versioduo/step/hardware/step.pdf

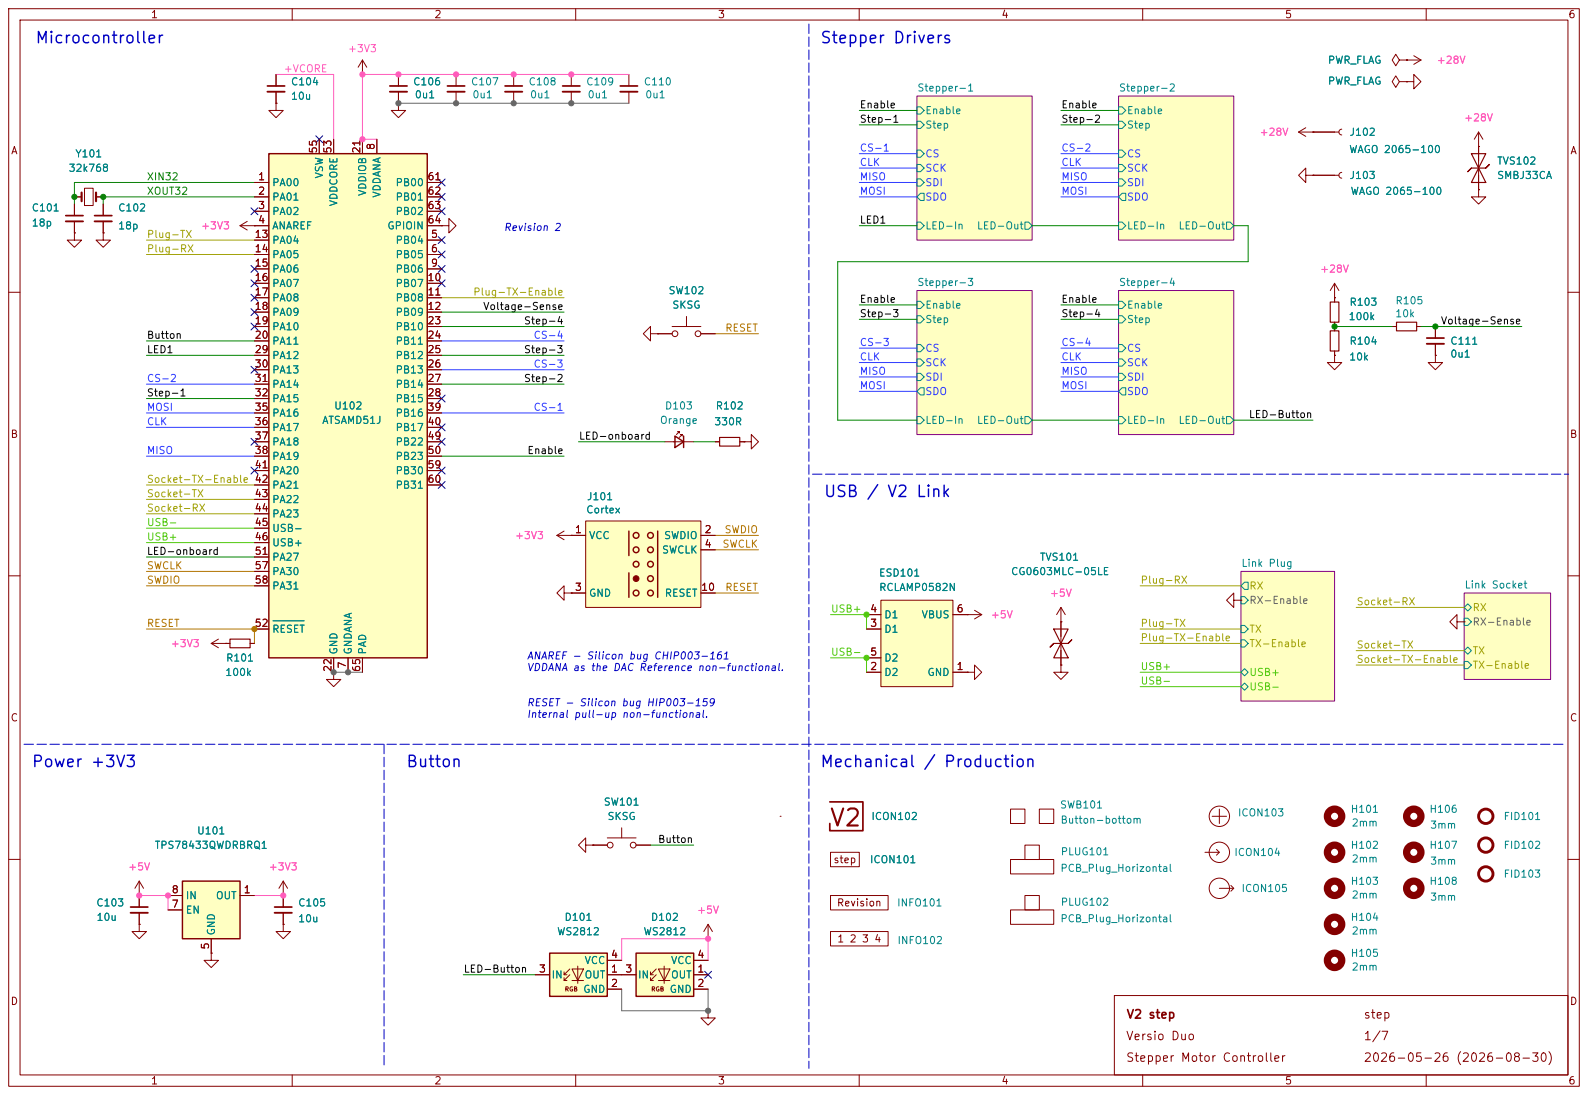
[picture p1: page 1]

LED-Out Stepper-4 CS

LED-Out Stepper-2 CS
Enable SDI LED-In SCK
Enable Step-1 MISO

Step

CS-4 MOSI XOUT32 Button CS-2
LED-Out Stepper-3 C102
Plug-TX

Step-4
LED-onboard CS-4 CS-3
Step-3

Plug-TX-Enable MISO

LED-onboard Socket-TX-Enable USB-
Socket-RX

VDDANA as the DAC Reference non-functional. Power +3V3

RESET - Silicon bug HIP003-159
Internal pull-up non-functional.

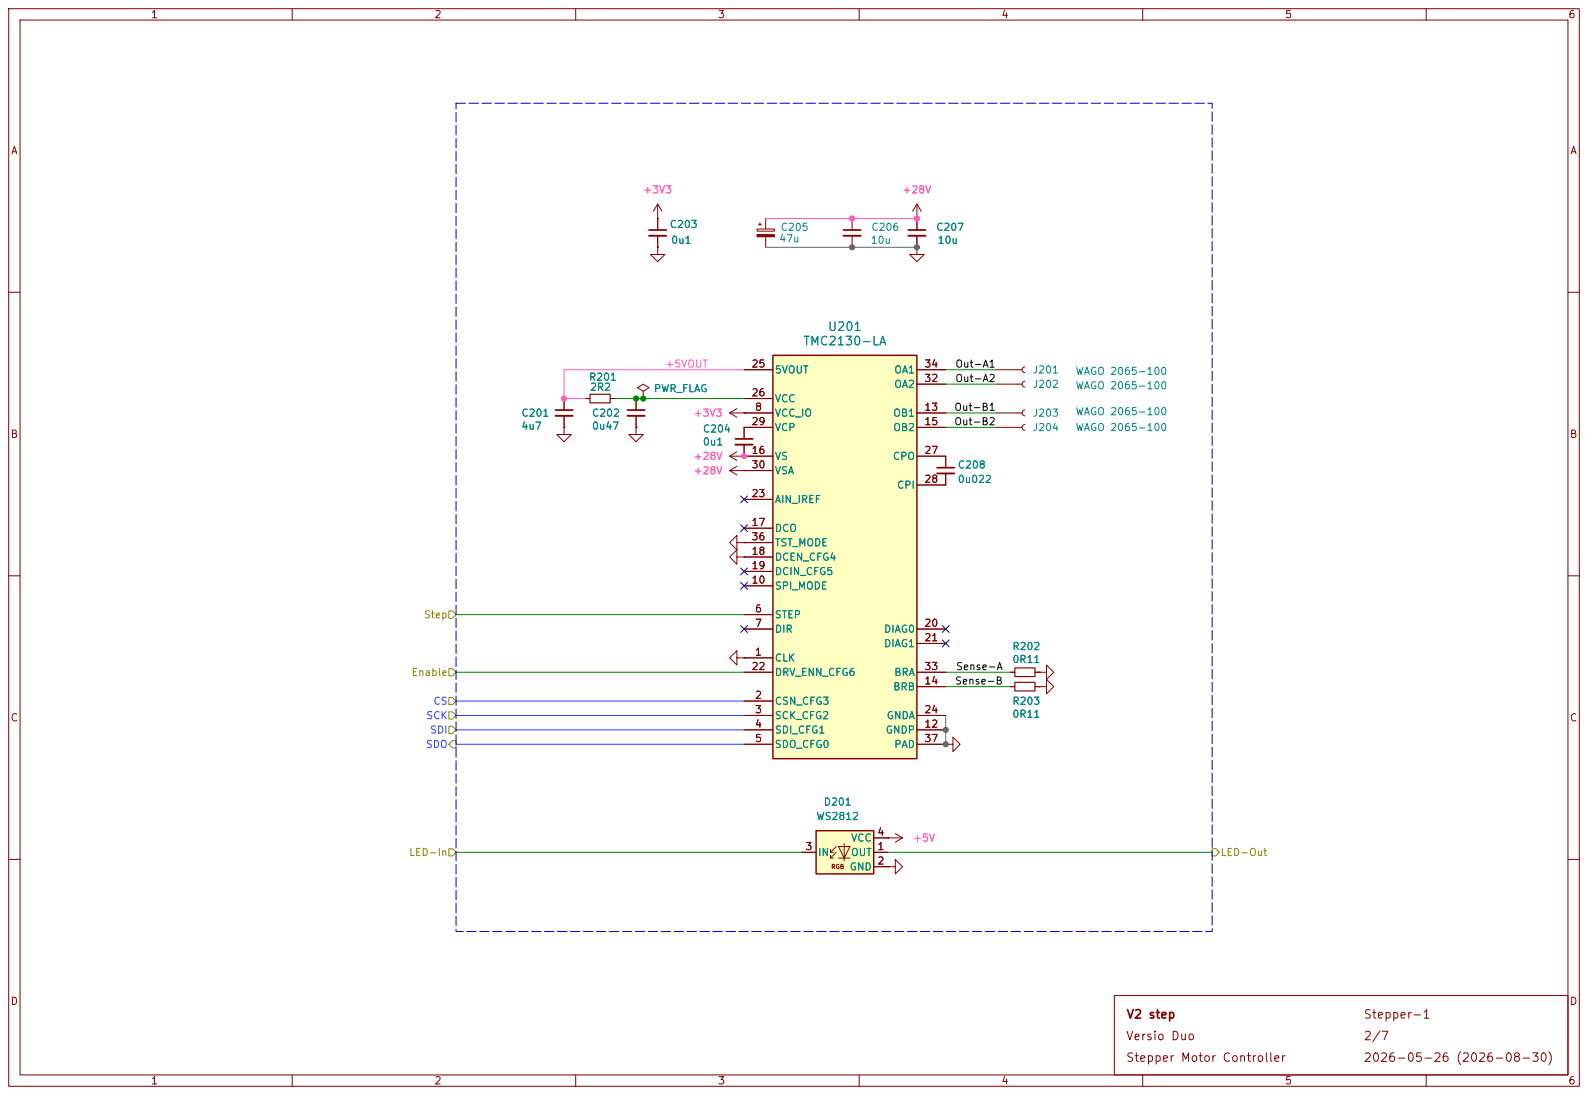
[picture p2: page 2]

0u1 PWR_FLAG

VCC_IO 8

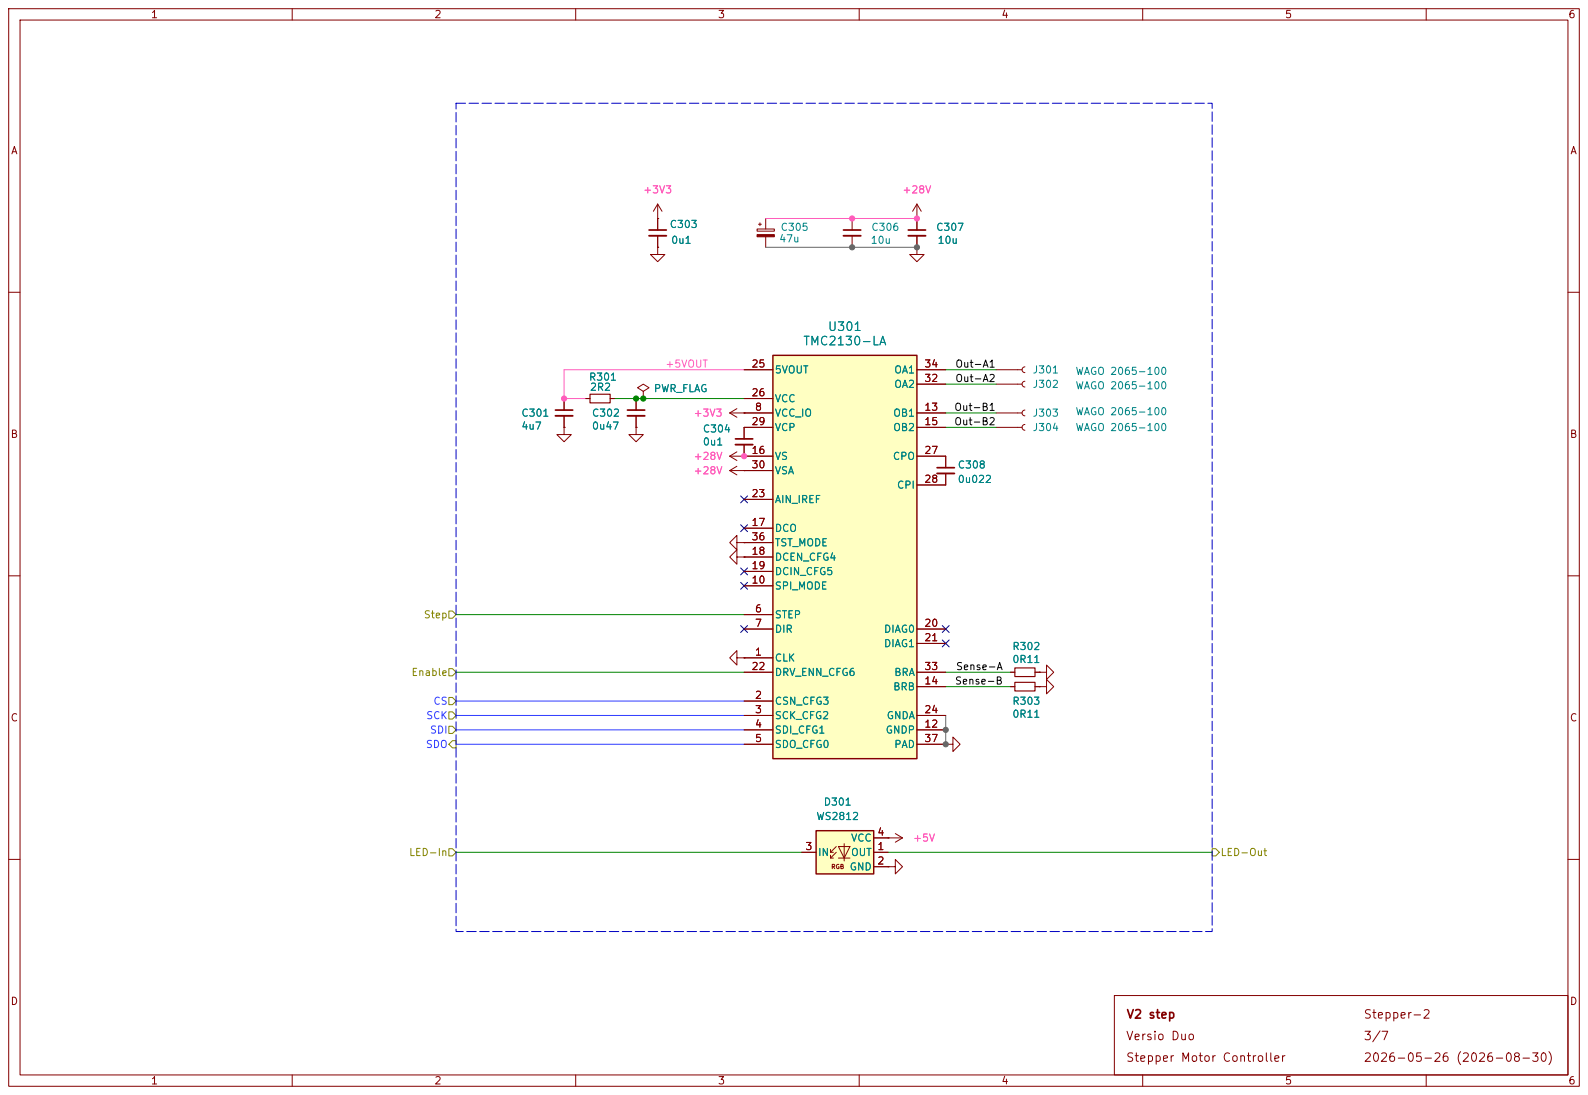
[picture p3: page 3]

CLK 1 CSN_CFG3 2 47u +28V VCC_IO 8 VCC_IO 8

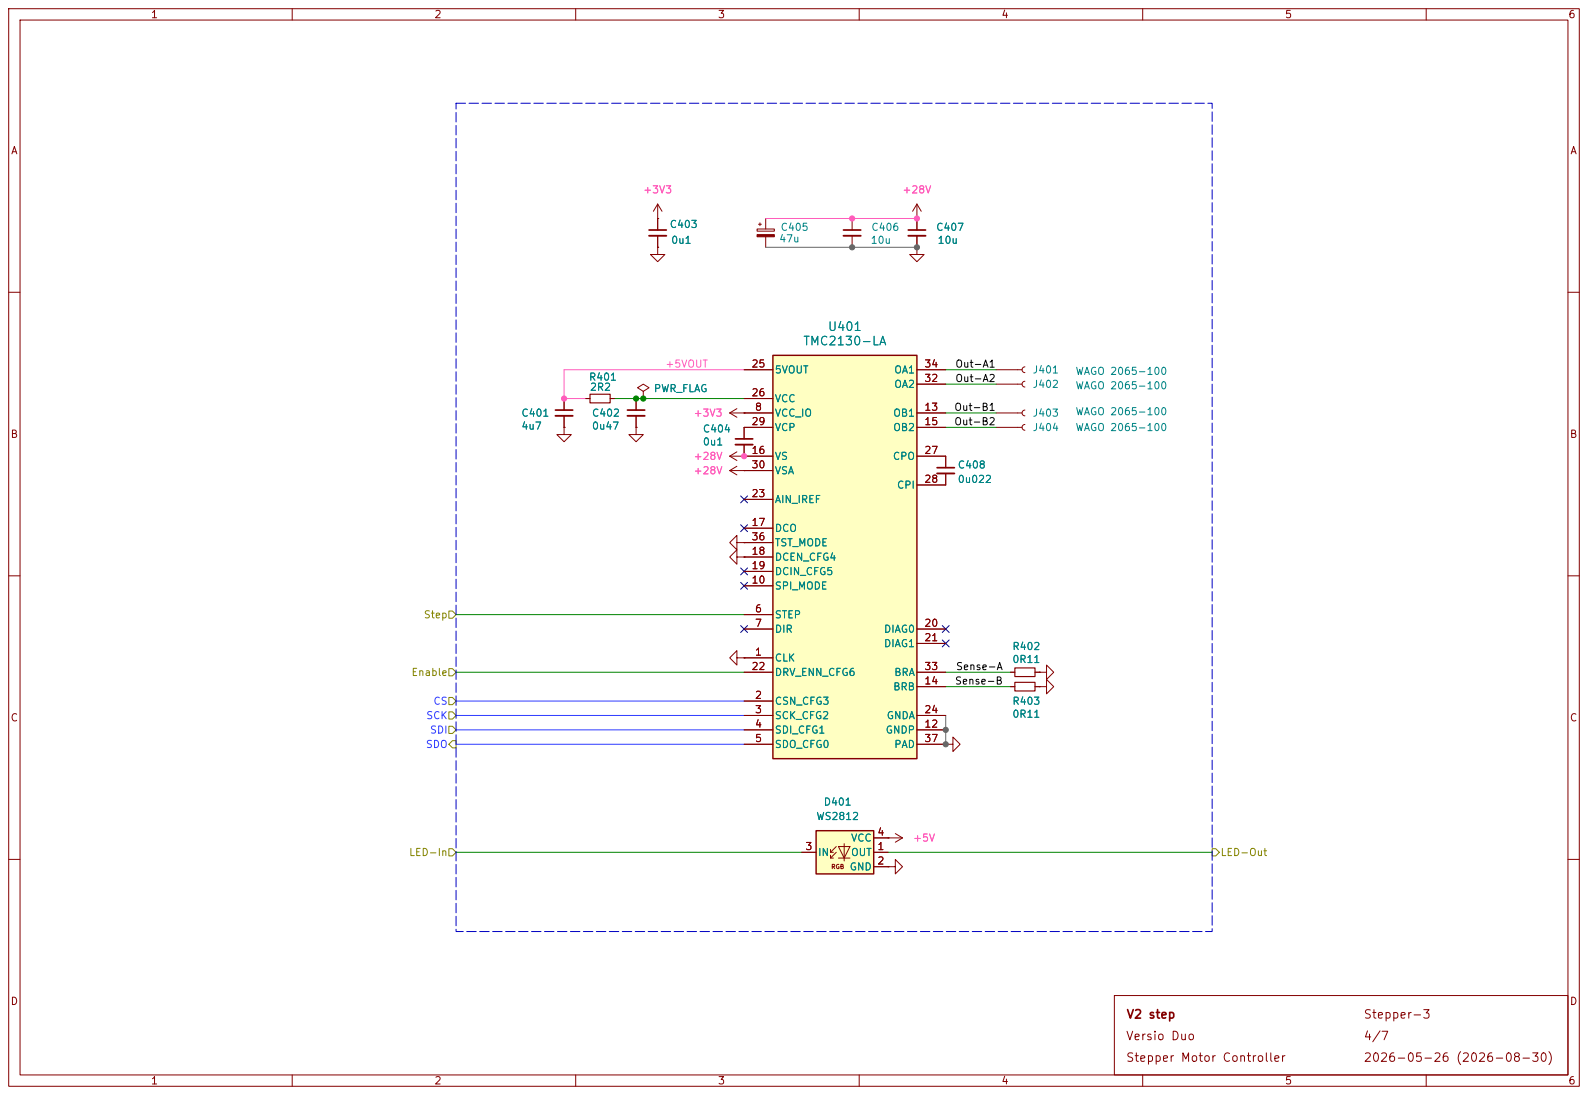
[picture p4: page 4]

0u1 +28V +3V3 +28V | VCC_IO 8

LED-Out Enable SDI CS
LED-In SDO

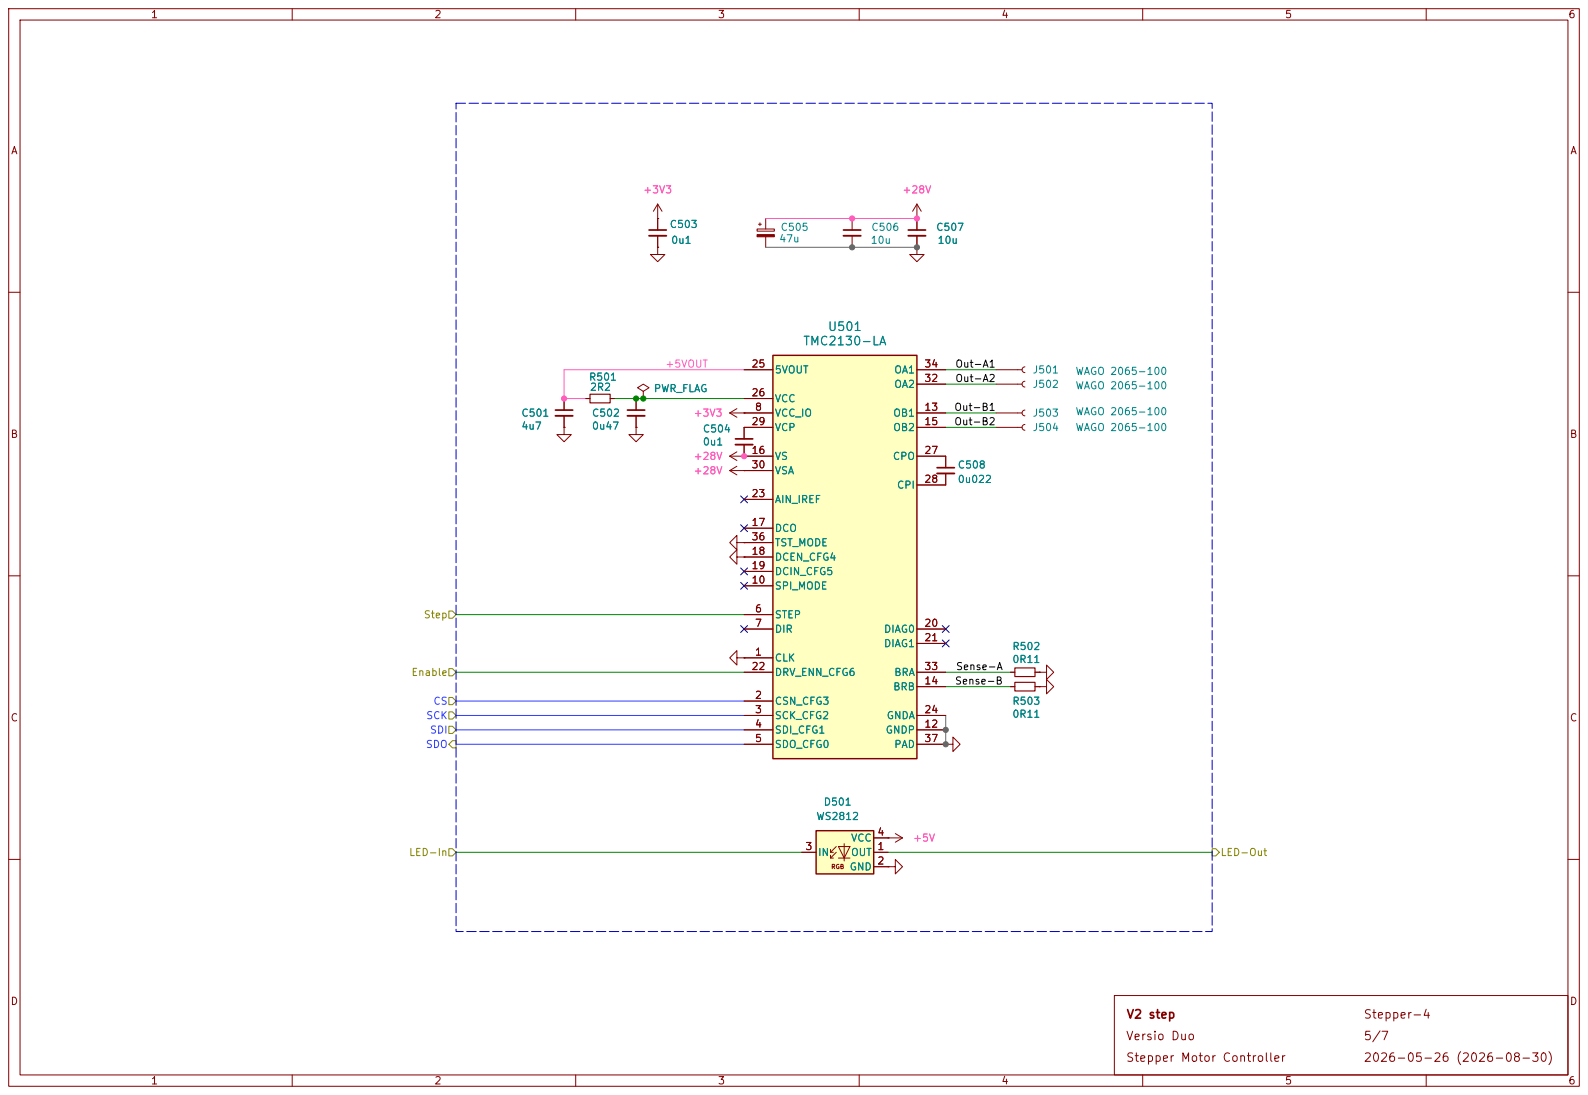
[picture p5: page 5]

TMC2130-LA +28V VCC_IO 8 VCC_IO 8 | Sense-A C507

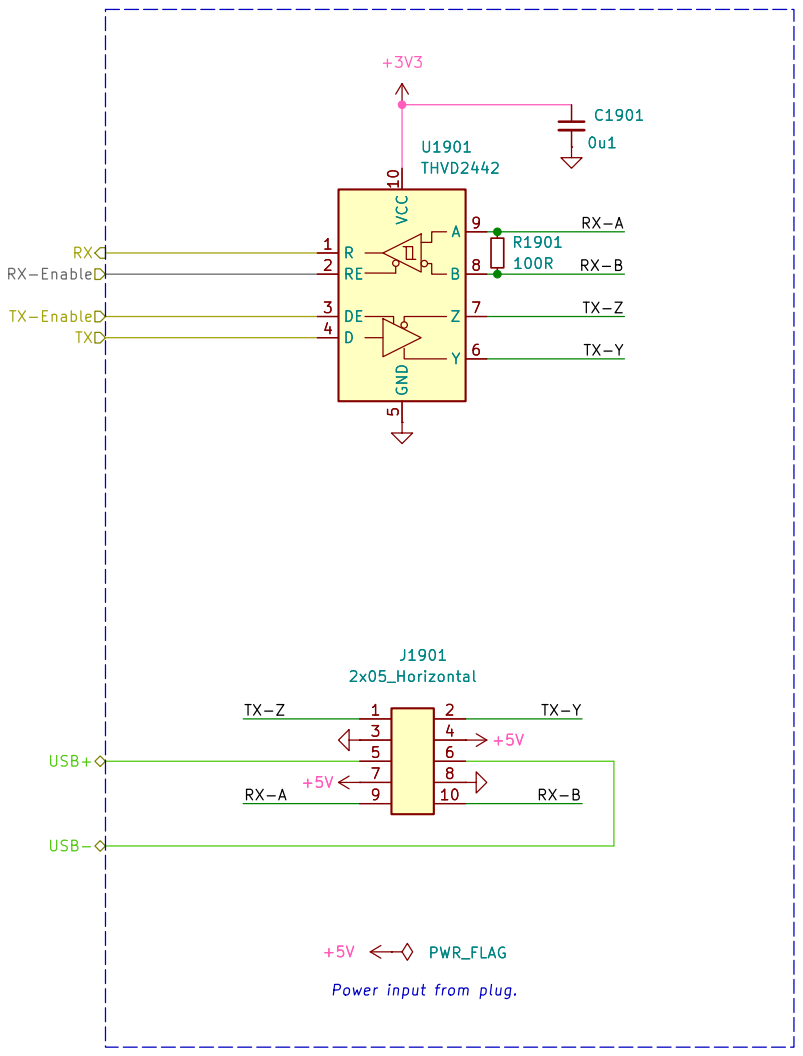
[picture p6: page 6]

0u1 USB+
TX RX-Enable USB-

TX-Y Power input from plug.

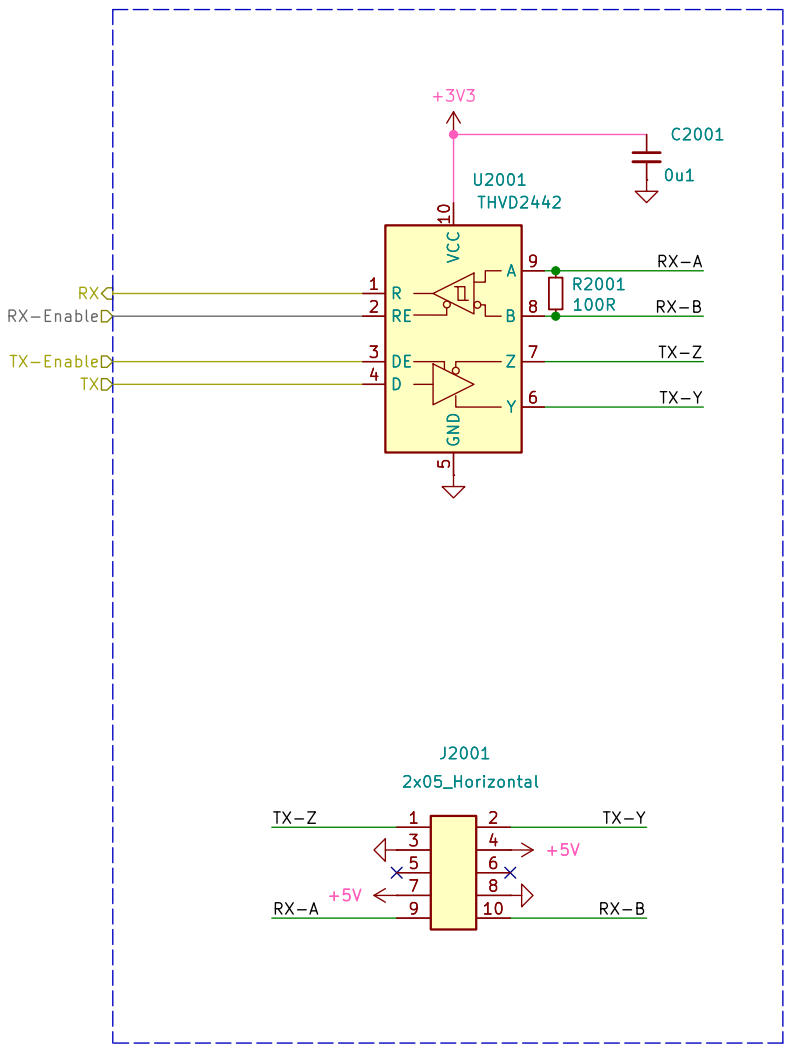
[picture p7: page 7]

TX-Enable RX-Enable
