versioduo/step/hardware/step.kicad_pcb

## KiCad design hardware/step.kicad_pcb (2026-08-30)

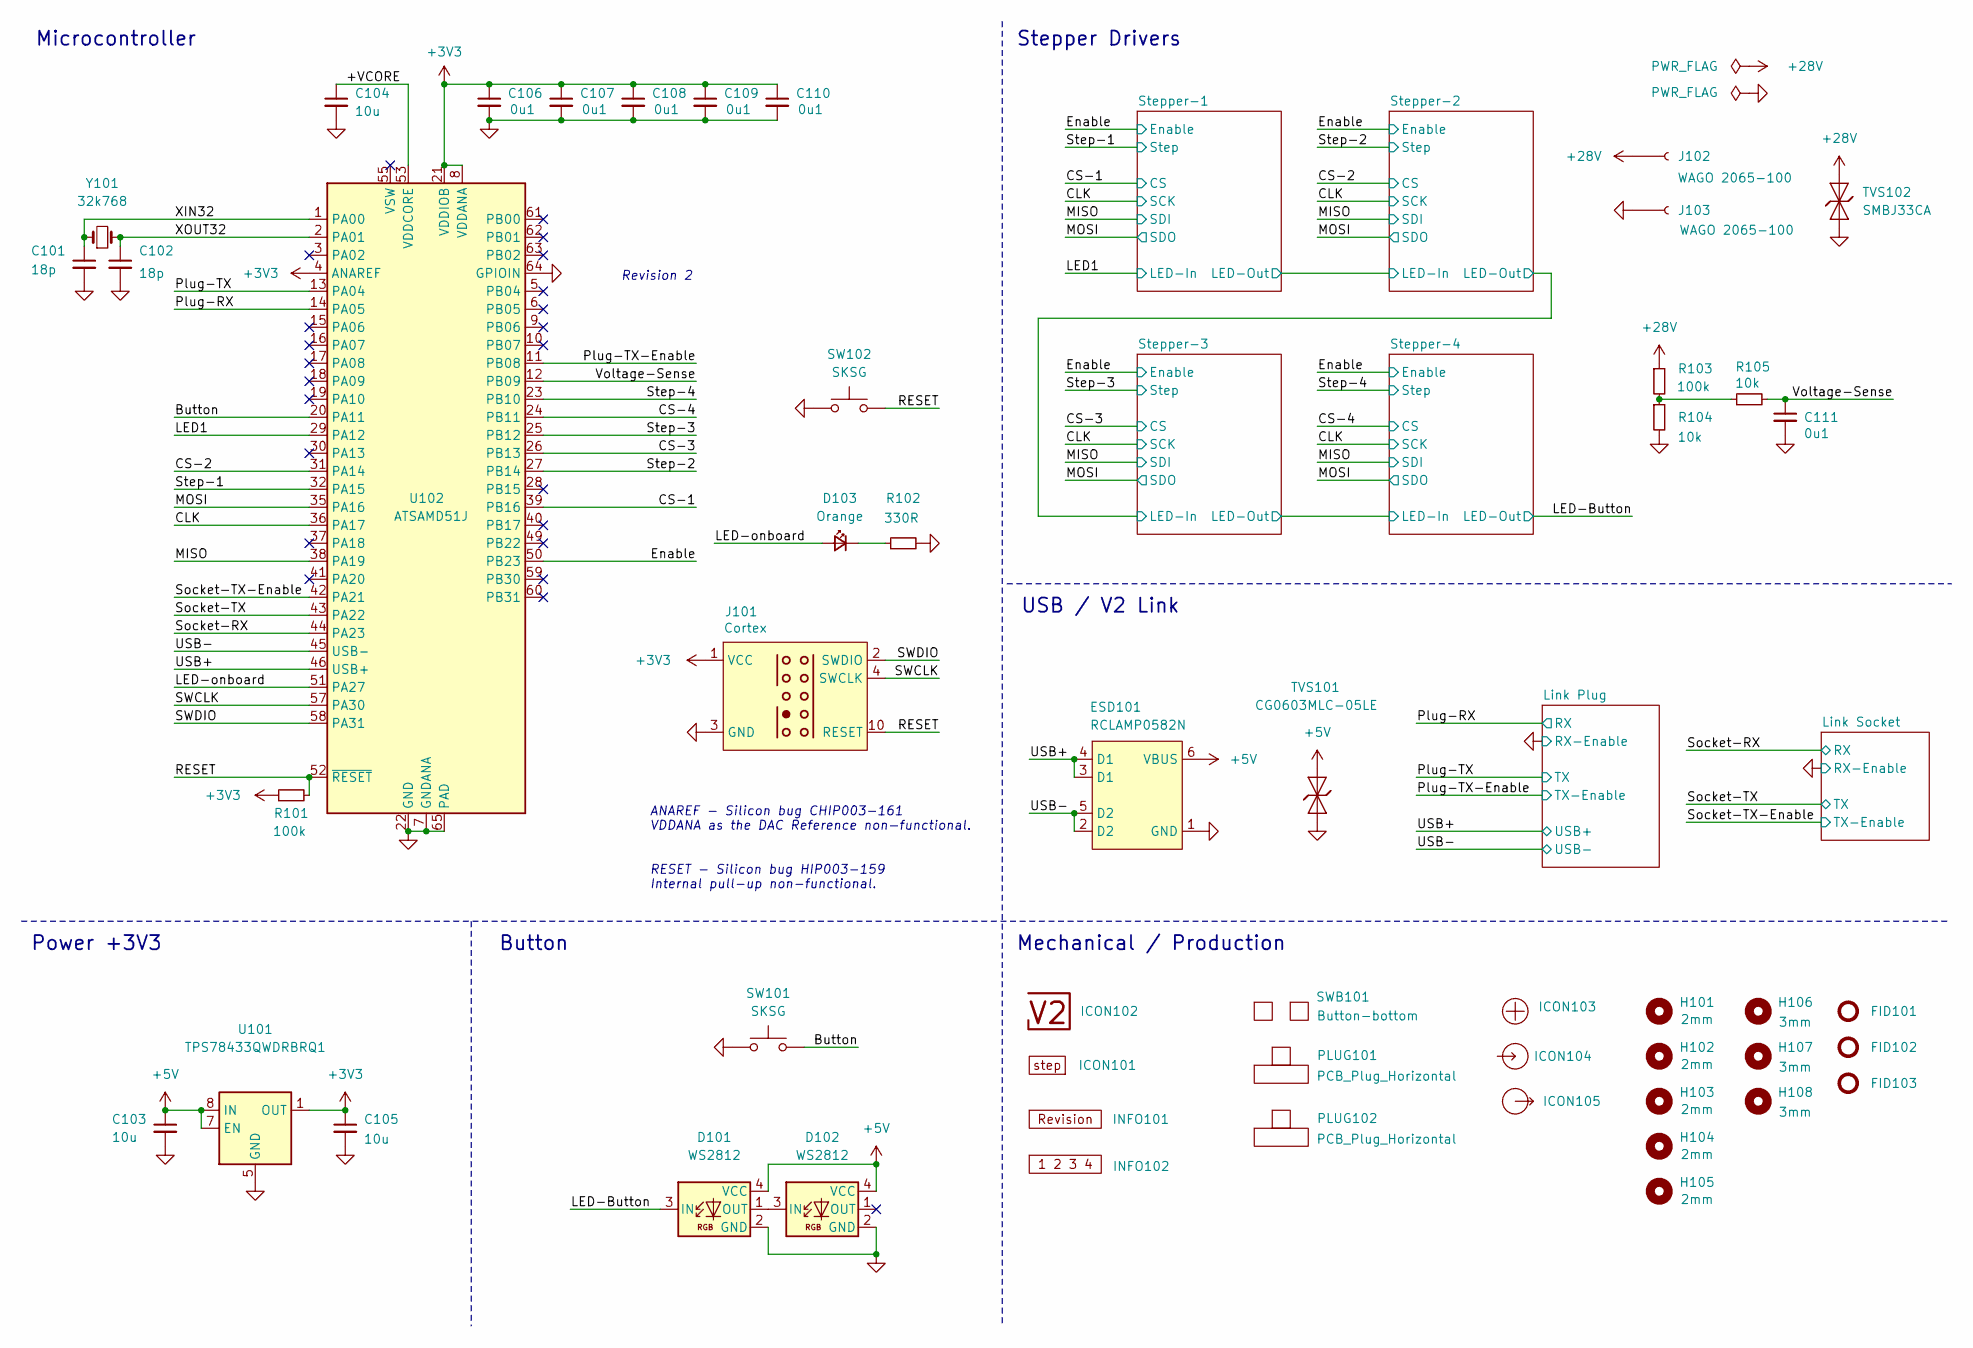
[picture p8: schematic step.kicad_sch, V2 step]

Parts:
C101, C102: 18p; C_1608; Rating 50V; Mouser 810-CGA3E2C0G1H180J
C103, C105: 10u; C_2012; Rating 25V; Mouser 810-C2012X5R1E106K
C104: 10u; C_1608; Rating 10V; Mouser 810-C1608X6S1A106M
C106, C107, C108, C109, C110, C111: 0u1; C_1608; Rating 50V; Mouser 810-CGA3E2X7R1H104MA
D101, D102: WS2812; WS2812-2020; Rating 15mA; LCSC C965555
D103: Orange; LED_1608; Rating 605nm; Mouser 755-SML-D12D1WT86
ESD101: RCLAMP0582N; SLP1210N6; Rating 20kV; Mouser 947-RCLAMP0582N.TCT
FID101, FID102, FID103: Fiducial_Paste; Fiducial_0.5mm_Mask1mm_Paste
H101, H102, H103, H104, H105: 2mm; MountingHole_2mm
H106, H107, H108: 3mm; MountingHole_3mm
ICON101: Board_step; Board_step_Small
ICON102: V2-logo; Logo_Small
ICON103: Plus; Plus_Small
ICON104: Arrow_In
ICON105: Arrow_Out
INFO101: Revision
INFO102: Layer_Numbers-6
J101: Cortex
J102, J103: WAGO 2065-100; 2065-100; Rating 9A
PLUG101, PLUG102: PCB_Plug_Horizontal
R101, R103: 100k; R_1608; Rating 100mW; Mouser 71-CRCW0603100KFKEAC
R102: 330R; R_1608; Rating 100mW; Mouser 71-CRCW0603330RFKEAC
R104, R105: 10k; R_1608; Rating 100mW; Mouser 71-CRCW060310K0FKEAC
SW101, SW102: SKSG; Rating 1.6N; Mouser 688-SKSGACE010
SWB101: Button-bottom; PCB_Button-bottom
TVS101: CG0603MLC-05LE; D_1608; Rating 5V; Mouser 652-CG0603MLC-05LE
TVS102: SMBJ33CA; D_SMB; Rating 33V; Mouser 652-SMBJ33CA-Q
U101: TPS78433QWDRBRQ1; VSON-8-1_3x3mm_P0.65_EP1.65x2.4mm; Rating 300mA; Mouser 595-TPS78433QWDRBRQ1
U102: ATSAMD51J; QFN-64-1EP_9x9mm_P0.5mm_EP4.8x4.8mm_ThermalVias; Rating Cortex-M4F; Mouser 556-ATSAMD51J19AMU
Y101: 32k768; Crystal_SMD_3215-2Pin_3.2x1.5mm; Rating 10ppm; Mouser 815-ABS0716632.768KT

Connections:
+3V3: C105.1, C106.1, C107.1, C108.1, C109.1, C110.1, J101.1 (VCC), R101.1, U101.1 (OUT), U102.4 (ANAREF), U102.8 (VDDANA), U102.21 (VDDIOB), U102.34 (VDDIO), U102.48 (VDDIO), U102.56 (VDDIO); also elsewhere on the board
+5V: C103.1, D101.4 (VCC), D102.4 (VCC), ESD101.6 (VBUS), TVS101.2 (A), U101.6 (EN), U101.7 (EN), U101.8 (IN); also elsewhere on the board
+28V: J102.1, R103.1, TVS102.2 (A); also elsewhere on the board
/+VCORE: C104.1, U102.53 (VDDCORE)
/Button: SW101.2, U102.20 (PA11)
/CLK: U102.36 (PA17); also elsewhere on the board
/CS-1: U102.39 (PB16); also elsewhere on the board
/CS-2: U102.31 (PA14); also elsewhere on the board
/CS-3: U102.26 (PB13); also elsewhere on the board
/CS-4: U102.24 (PB11); also elsewhere on the board
/Enable: U102.50 (PB23); also elsewhere on the board
/LED1: U102.29 (PA12); also elsewhere on the board
/LED-Button: D101.3 (IN); also elsewhere on the board
/LED-onboard: D103.2 (A), U102.51 (PA27)
/MISO: U102.38 (PA19); also elsewhere on the board
/MOSI: U102.35 (PA16); also elsewhere on the board
/Plug-RX: U102.14 (PA05); also elsewhere on the board
/Plug-TX: U102.13 (PA04); also elsewhere on the board
/Plug-TX-Enable: U102.11 (PB08); also elsewhere on the board
/RESET: J101.10 (RESET), R101.2, SW102.2, U102.52 (~RESET)
/SWCLK: J101.4 (SWCLK), U102.57 (PA30)
/SWDIO: J101.2 (SWDIO), U102.58 (PA31)
/Socket-RX: U102.44 (PA23); also elsewhere on the board
/Socket-TX: U102.43 (PA22); also elsewhere on the board
/Socket-TX-Enable: U102.42 (PA21); also elsewhere on the board
/Step-1: U102.32 (PA15); also elsewhere on the board
/Step-2: U102.27 (PB14); also elsewhere on the board
/Step-3: U102.25 (PB12); also elsewhere on the board
/Step-4: U102.23 (PB10); also elsewhere on the board
/USB+: ESD101.3 (D1), ESD101.4 (D1), U102.46 (USB+); also elsewhere on the board
/USB-: ESD101.2 (D2), ESD101.5 (D2), U102.45 (USB-); also elsewhere on the board
/Voltage-Sense: C111.1, R105.2, U102.12 (PB09)
/XIN32: C101.1, U102.1 (PA00), Y101.1
/XOUT32: C102.1, U102.2 (PA01), Y101.2
GND: C101.2, C102.2, C103.2, C104.2, C105.2, C106.2, C107.2, C108.2, C109.2, C110.2, C111.2, D101.2 (GND), D102.2 (GND), ESD101.1 (GND), J101.3 (GND), J101.5 (GND), J103.1, R102.2, R104.2, SW101.1, SW102.1, TVS101.1 (K), TVS102.1 (K), U101.5 (GND), U101.9 (GND), U102.7 (GNDANA), U102.22 (GND), U102.33 (GND), U102.47 (GND), U102.54 (GND), U102.64 (GPIOIN), U102.65 (PAD); also elsewhere on the board
unnamed: D101.1 (OUT), D102.3 (IN)
unnamed: D103.1 (K), R102.1
unnamed: R103.2, R104.1, R105.1

Notes on the sheet:
 ANAREF - Silicon bug CHIP003-161 VDDANA as the DAC Reference non-functional.
Stepper Drivers
RESET -  Silicon bug HIP003-159 Internal pull-up non-functional.
Button
Revision 2
USB / V2 Link
Mechanical / Production
Power +3V3
Microcontroller

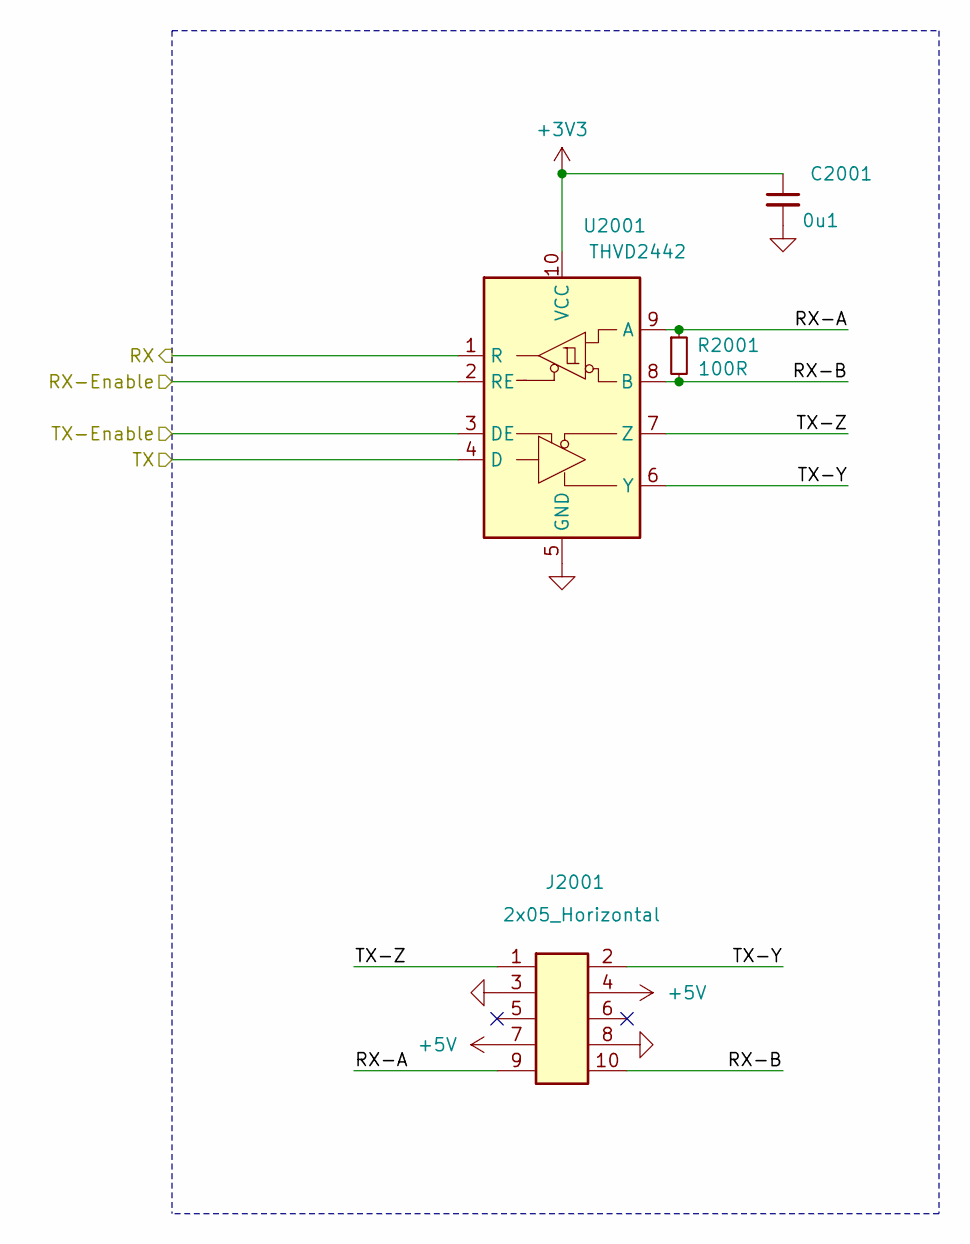
[picture p9: schematic Link-Socket.kicad_sch, V2 step]

Parts:
C2001: 0u1; C_1608; Rating 50V; Mouser 810-CGA3E2X7R1H104MA
J2001: 2x05_Horizontal; PinHeader_2x05_P1.27mm_Horizontal; Rating 1A; Mouser 649-200211120001T4LF
R2001: 100R; R_1608; Rating 330mW; Mouser 71-CRCW0603100RFKEAH
U2001: THVD2442; VSON-10-4-1EP_3x3mm_P0.5mm_EP1.65x2.4mm_ThermalVias; Rating 20Mbps; Mouser 595-THVD2442DRCR

Connections:
+3V3: C2001.1, U2001.10 (VCC); also elsewhere on the board
+5V: J2001.4, J2001.7; also elsewhere on the board
/Link Socket/RX-A: J2001.9, R2001.1, U2001.9 (A)
/Link Socket/RX-B: J2001.10, R2001.2, U2001.8 (B)
/Link Socket/TX-Y: J2001.2, U2001.6 (Y)
/Link Socket/TX-Z: J2001.1, U2001.7 (Z)
/Socket-RX: U2001.1 (R); also elsewhere on the board
/Socket-TX: U2001.4 (D); also elsewhere on the board
/Socket-TX-Enable: U2001.3 (DE); also elsewhere on the board
GND: C2001.2, J2001.3, J2001.8, U2001.2 (RE), U2001.5 (GND), U2001.11 (GND); also elsewhere on the board

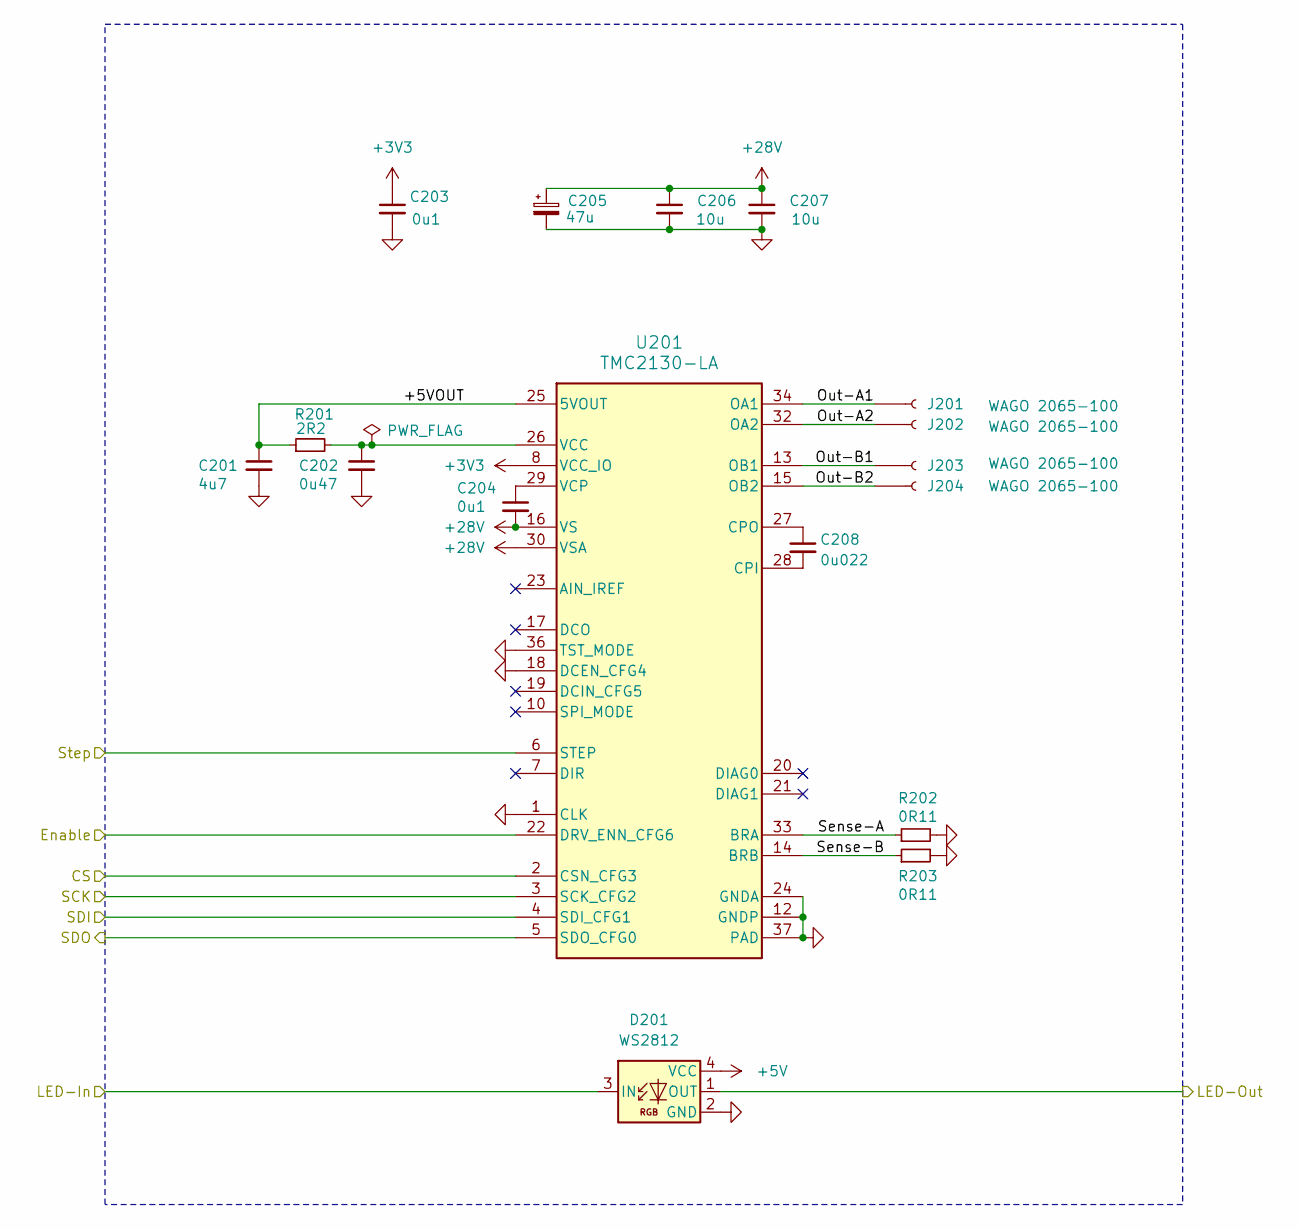
[picture p10: schematic Stepper.kicad_sch, V2 step]

Parts:
C201: 4u7; C_1608; Rating 10V; Mouser 603-CC603KRX5R6BB475
C202: 0u47; C_1608; Rating 50V; Mouser 810-CGA3E3X7R1H474KB
C203, C204: 0u1; C_1608; Rating 50V; Mouser 810-CGA3E2X7R1H104MA
C205: 47u; CP_Elec_6.3x5.8; Rating 35V; Mouser 667-EEE-FK1V470P
C206, C207: 10u; C_3225; Rating 50V; Mouser 810-CNC6P1X7R1H106K2
C208: 0u022; C_1608; Rating 50V; Mouser 603-CC603KPX7R9BB223
D201: WS2812; WS2812-2020; Rating 15mA; LCSC C965555
J201, J202, J203, J204: WAGO 2065-100; 2065-100; Rating 9A
R201: 2R2; R_1608; Rating 500mW; Mouser 71-RCS06032R20JNEA
R202, R203: 0R11; R_2012; Rating 500mW; Mouser 667-ERJ-6DSFR11V
U201: TMC2130-LA; QFN-36-5X6; Rating 2A; LCSC C915795

Connections:
+3V3: C203.1, U201.8 (VCC_IO); also elsewhere on the board
+5V: D201.4 (VCC); also elsewhere on the board
+28V: C204.2, C205.1, C206.1, C207.1, U201.16 (VS), U201.30 (VSA), U201.31 (VS); also elsewhere on the board
/CLK: U201.3 (SCK_CFG2); also elsewhere on the board
/CS-1: U201.2 (CSN_CFG3); also elsewhere on the board
/Enable: U201.22 (DRV_ENN_CFG6); also elsewhere on the board
/LED1: D201.3 (IN); also elsewhere on the board
/MISO: U201.4 (SDI_CFG1); also elsewhere on the board
/MOSI: U201.5 (SDO_CFG0); also elsewhere on the board
/Step-1: U201.6 (STEP); also elsewhere on the board
/Stepper-1/+5VOUT: C201.1, R201.1, U201.25 (5VOUT)
/Stepper-1/LED-Out: D201.1 (OUT); also elsewhere on the board
/Stepper-1/Out-A1: J201.1, U201.34 (OA1)
/Stepper-1/Out-A2: J202.1, U201.32 (OA2)
/Stepper-1/Out-B1: J203.1, U201.13 (OB1)
/Stepper-1/Out-B2: J204.1, U201.15 (OB2)
/Stepper-1/Sense-A: R202.1, U201.33 (BRA)
/Stepper-1/Sense-B: R203.1, U201.14 (BRB)
GND: C201.2, C202.2, C203.2, C205.2, C206.2, C207.2, D201.2 (GND), R202.2, R203.2, U201.1 (CLK), U201.12 (GNDP), U201.18 (DCEN_CFG4), U201.24 (GNDA), U201.35 (GNDP), U201.36 (TST_MODE), U201.37 (PAD); also elsewhere on the board
unnamed: C208.2, U201.28 (CPI)
unnamed: C208.1, U201.27 (CPO)
unnamed: C202.1, R201.2, U201.26 (VCC)
unnamed: C204.1, U201.29 (VCP)

Parts of its further copies:
C301, C401, C501: 4u7; C_1608; Rating 10V; Mouser 603-CC603KRX5R6BB475
C302, C402, C502: 0u47; C_1608; Rating 50V; Mouser 810-CGA3E3X7R1H474KB
C303, C304, C403, C404, C503, C504: 0u1; C_1608; Rating 50V; Mouser 810-CGA3E2X7R1H104MA
C305, C405, C505: 47u; CP_Elec_6.3x5.8; Rating 35V; Mouser 667-EEE-FK1V470P
C306, C307, C406, C407, C506, C507: 10u; C_3225; Rating 50V; Mouser 810-CNC6P1X7R1H106K2
C308, C408, C508: 0u022; C_1608; Rating 50V; Mouser 603-CC603KPX7R9BB223
D301, D401, D501: WS2812; WS2812-2020; Rating 15mA; LCSC C965555
J301, J302, J303, J304, J401, J402, J403, J404, J501, J502, J503, J504: WAGO 2065-100; 2065-100; Rating 9A
R301, R401, R501: 2R2; R_1608; Rating 500mW; Mouser 71-RCS06032R20JNEA
R302, R303, R402, R403, R502, R503: 0R11; R_2012; Rating 500mW; Mouser 667-ERJ-6DSFR11V
U301, U401, U501: TMC2130-LA; QFN-36-5X6; Rating 2A; LCSC C915795

Connections of its further copies:
+3V3: C303.1, C403.1, C503.1, U301.8 (VCC_IO), U401.8 (VCC_IO), U501.8 (VCC_IO); also elsewhere on the board
+5V: D301.4 (VCC), D401.4 (VCC), D501.4 (VCC); also elsewhere on the board
+28V: C304.2, C305.1, C306.1, C307.1, C404.2, C405.1, C406.1, C407.1, C504.2, C505.1, C506.1, C507.1, U301.16 (VS), U301.30 (VSA), U301.31 (VS), U401.16 (VS), U401.30 (VSA), U401.31 (VS), U501.16 (VS), U501.30 (VSA), U501.31 (VS); also elsewhere on the board
/CLK: U301.3 (SCK_CFG2), U401.3 (SCK_CFG2), U501.3 (SCK_CFG2); also elsewhere on the board
/CS-2: U301.2 (CSN_CFG3); also elsewhere on the board
/CS-3: U401.2 (CSN_CFG3); also elsewhere on the board
/CS-4: U501.2 (CSN_CFG3); also elsewhere on the board
/Enable: U301.22 (DRV_ENN_CFG6), U401.22 (DRV_ENN_CFG6), U501.22 (DRV_ENN_CFG6); also elsewhere on the board
/LED-Button: D501.1 (OUT); also elsewhere on the board
/MISO: U301.4 (SDI_CFG1), U401.4 (SDI_CFG1), U501.4 (SDI_CFG1); also elsewhere on the board
/MOSI: U301.5 (SDO_CFG0), U401.5 (SDO_CFG0), U501.5 (SDO_CFG0); also elsewhere on the board
/Step-2: U301.6 (STEP); also elsewhere on the board
/Step-3: U401.6 (STEP); also elsewhere on the board
/Step-4: U501.6 (STEP); also elsewhere on the board
/Stepper-1/LED-Out: D301.3 (IN); also elsewhere on the board
/Stepper-2/+5VOUT: C301.1, R301.1, U301.25 (5VOUT)
/Stepper-2/LED-Out: D301.1 (OUT), D401.3 (IN)
/Stepper-2/Out-A1: J301.1, U301.34 (OA1)
/Stepper-2/Out-A2: J302.1, U301.32 (OA2)
/Stepper-2/Out-B1: J303.1, U301.13 (OB1)
/Stepper-2/Out-B2: J304.1, U301.15 (OB2)
/Stepper-2/Sense-A: R302.1, U301.33 (BRA)
/Stepper-2/Sense-B: R303.1, U301.14 (BRB)
/Stepper-3/+5VOUT: C401.1, R401.1, U401.25 (5VOUT)
/Stepper-3/LED-Out: D401.1 (OUT), D501.3 (IN)
/Stepper-3/Out-A1: J401.1, U401.34 (OA1)
/Stepper-3/Out-A2: J402.1, U401.32 (OA2)
/Stepper-3/Out-B1: J403.1, U401.13 (OB1)
/Stepper-3/Out-B2: J404.1, U401.15 (OB2)
/Stepper-3/Sense-A: R402.1, U401.33 (BRA)
/Stepper-3/Sense-B: R403.1, U401.14 (BRB)
/Stepper-4/+5VOUT: C501.1, R501.1, U501.25 (5VOUT)
/Stepper-4/Out-A1: J501.1, U501.34 (OA1)
/Stepper-4/Out-A2: J502.1, U501.32 (OA2)
/Stepper-4/Out-B1: J503.1, U501.13 (OB1)
/Stepper-4/Out-B2: J504.1, U501.15 (OB2)
/Stepper-4/Sense-A: R502.1, U501.33 (BRA)
/Stepper-4/Sense-B: R503.1, U501.14 (BRB)
GND: C301.2, C302.2, C303.2, C305.2, C306.2, C307.2, C401.2, C402.2, C403.2, C405.2, C406.2, C407.2, C501.2, C502.2, C503.2, C505.2, C506.2, C507.2, D301.2 (GND), D401.2 (GND), D501.2 (GND), R302.2, R303.2, R402.2, R403.2, R502.2, R503.2, U301.1 (CLK), U301.12 (GNDP), U301.18 (DCEN_CFG4), U301.24 (GNDA), U301.35 (GNDP), U301.36 (TST_MODE), U301.37 (PAD), U401.1 (CLK), U401.12 (GNDP), U401.18 (DCEN_CFG4), U401.24 (GNDA), U401.35 (GNDP), U401.36 (TST_MODE), U401.37 (PAD), U501.1 (CLK), U501.12 (GNDP), U501.18 (DCEN_CFG4), U501.24 (GNDA), U501.35 (GNDP), U501.36 (TST_MODE), U501.37 (PAD); also elsewhere on the board
unnamed: C308.2, U301.28 (CPI)
unnamed: C308.1, U301.27 (CPO)
unnamed: C302.1, R301.2, U301.26 (VCC)
unnamed: C304.1, U301.29 (VCP)
unnamed: C408.2, U401.28 (CPI)
unnamed: C408.1, U401.27 (CPO)
unnamed: C402.1, R401.2, U401.26 (VCC)
unnamed: C404.1, U401.29 (VCP)
unnamed: C508.2, U501.28 (CPI)
unnamed: C508.1, U501.27 (CPO)
unnamed: C502.1, R501.2, U501.26 (VCC)
unnamed: C504.1, U501.29 (VCP)

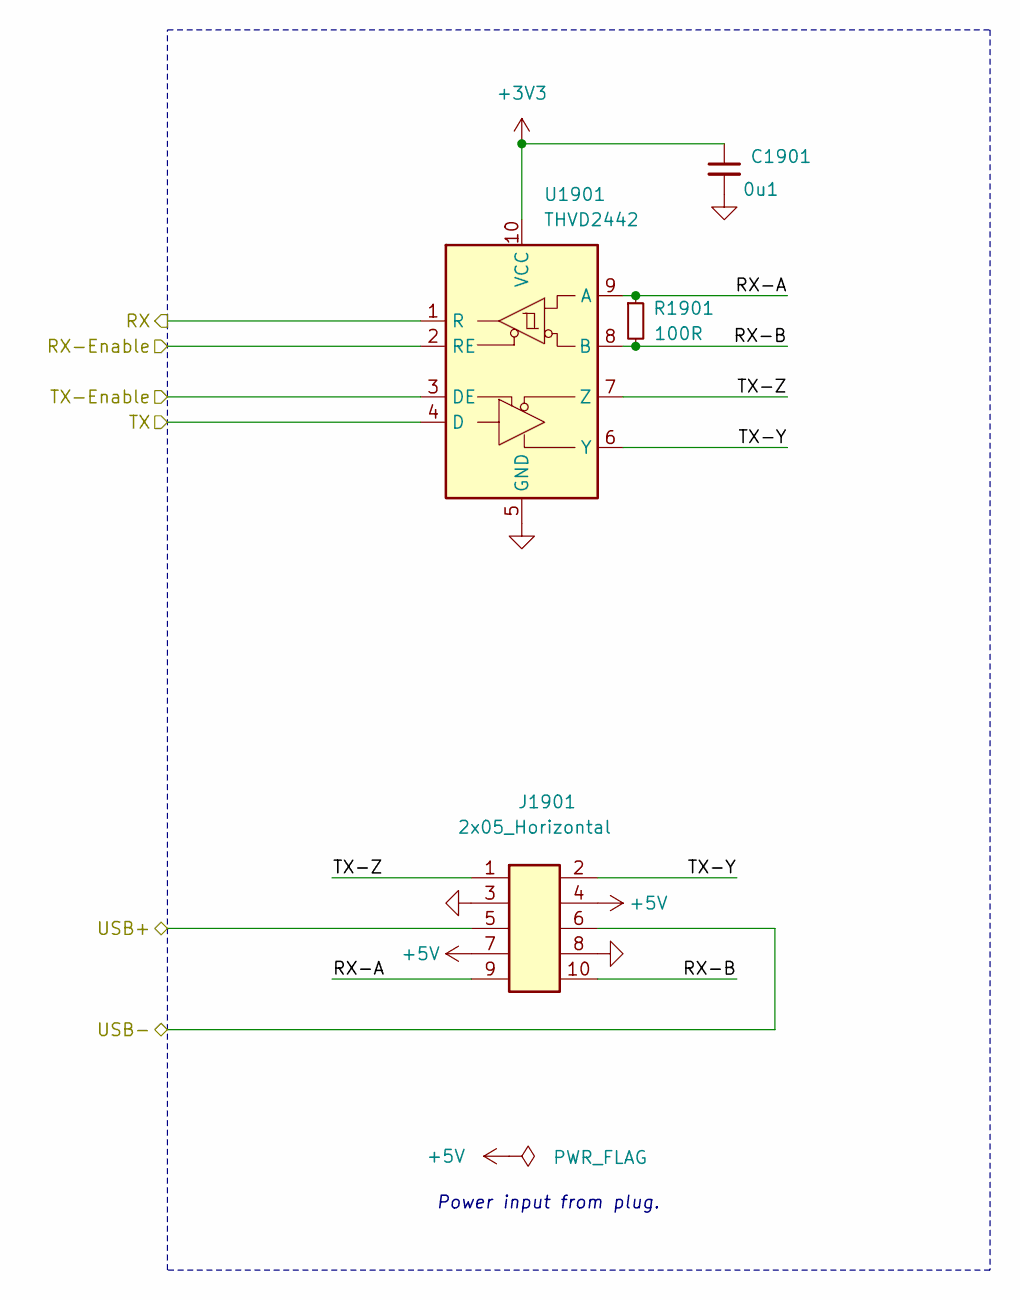
[picture p11: schematic Link-Plug.kicad_sch, V2 step]

Parts:
C1901: 0u1; C_1608; Rating 50V; Mouser 810-CGA3E2X7R1H104MA
J1901: 2x05_Horizontal; PinHeader_2x05_P1.27mm_Horizontal; Rating 1A; Mouser 649-200211120001T4LF
R1901: 100R; R_1608; Rating 330mW; Mouser 71-CRCW0603100RFKEAH
U1901: THVD2442; VSON-10-4-1EP_3x3mm_P0.5mm_EP1.65x2.4mm_ThermalVias; Rating 20Mbps; Mouser 595-THVD2442DRCR

Connections:
+3V3: C1901.1, U1901.10 (VCC); also elsewhere on the board
+5V: J1901.4, J1901.7; also elsewhere on the board
/Link Plug/RX-A: J1901.9, R1901.1, U1901.9 (A)
/Link Plug/RX-B: J1901.10, R1901.2, U1901.8 (B)
/Link Plug/TX-Y: J1901.2, U1901.6 (Y)
/Link Plug/TX-Z: J1901.1, U1901.7 (Z)
/Plug-RX: U1901.1 (R); also elsewhere on the board
/Plug-TX: U1901.4 (D); also elsewhere on the board
/Plug-TX-Enable: U1901.3 (DE); also elsewhere on the board
/USB+: J1901.5; also elsewhere on the board
/USB-: J1901.6; also elsewhere on the board
GND: C1901.2, J1901.3, J1901.8, U1901.2 (RE), U1901.5 (GND), U1901.11 (GND); also elsewhere on the board

Notes on the sheet:
Power input from plug.

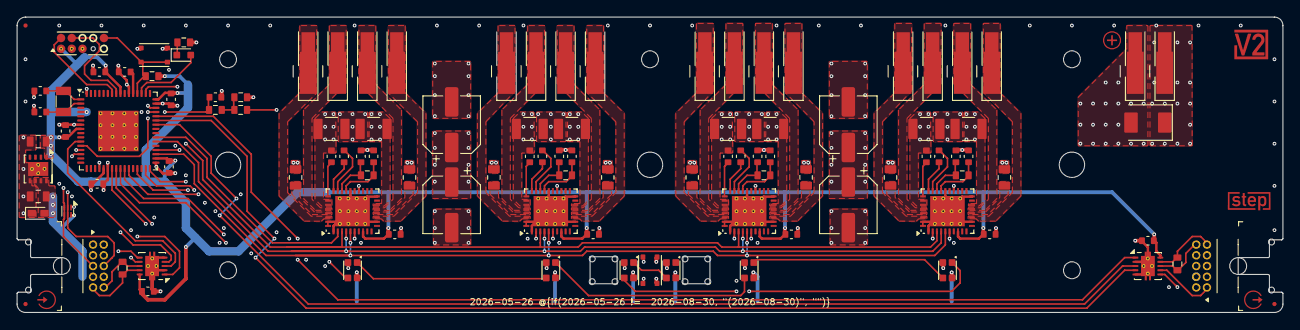
[picture p12: board step.kicad_pcb from above]

Board: 6 copper layers, 150.0 x 35.0 mm, 127 parts (0 on the bottom side), 93 nets.
