versioduo/step/firmware/step/step.ino

#include <V2Base.h>
#include <V2Buttons.h>
#include <V2Device.h>
#include <V2LED.h>
#include <V2Link.h>
#include <V2MIDI.h>
#include <V2Music.h>
#include <V2PowerSupply.h>
#include <V2Stepper.h>

namespace {
  constexpr uint8_t            nSteppers{4};
  V2Device::Info               Info{V2DeviceInfo("com.versioduo.step", 23, "versioduo:samd:step")};
  V2LED::WS2812<nSteppers + 2> LED(PIN_LED_WS2812, sercom2, SPI_PAD_0_SCK_1, PIO_SERCOM);
  V2Link::Port                 Plug(&SerialPlug, PIN_SERIAL_PLUG_TX_ENABLE, "plug");
  V2Link::Port                 Socket(&SerialSocket, PIN_SERIAL_SOCKET_TX_ENABLE, "socket");
  V2Base::Timer::Periodic      Timer(2, 200000);
  V2Base::Analog::ADC          ADC(V2Base::Analog::ADC::getID(PIN_VOLTAGE_SENSE));

  class Stepper : public V2Stepper::Motor {
  public:
    Stepper(const Motor::Config conf, uint8_t index) :
      Motor(conf, &Timer, &SPI, PIN_DRIVER_SELECT + index, PIN_DRIVER_STEP + index),
      _index(index) {}

  private:
    const uint8_t _index;

    void handleMovement(Move move) override {
      switch (move) {
        case Move::Forward:
          LED.hsv({V2Colour::Cyan, 1, 0.4}, _index);
          break;

        case Move::Reverse:
          LED.hsv({V2Colour::Orange, 1, 0.4}, _index);
          break;

        case Move::Stop:
          LED.hsv({V2Colour::Green, 1, 0.2}, _index);
          break;
      }
    }
  } Steppers[nSteppers]{
    Stepper(
      {
        .ampere{0.7},
        .microstepsShift{4},
        .home{.speed{750}, .stall{0.04}},
        .speed{.min{50}, .max{2400}, .accel{10000}},
      },
      0),
    Stepper(
      {
        .ampere{0.7},
        .microstepsShift{4},
        .home{.speed{750}, .stall{0.04}},
        .speed{.min{50}, .max{2400}, .accel{10000}},
      },
      1),
    Stepper(
      {
        .ampere{0.7},
        .microstepsShift{4},
        .home{.speed{750}, .stall{0.04}},
        .speed{.min{50}, .max{2400}, .accel{10000}},
      },
      2),
    Stepper(
      {
        .ampere{0.7},
        .microstepsShift{4},
        .home{.speed{750}, .stall{0.04}},
        .speed{.min{50}, .max{2400}, .accel{10000}},
      },
      3),
  };

  class Power : public V2PowerSupply {
  public:
    Power() : V2PowerSupply({.min{4.8}, .max{30}}) {}

    void begin() {
      pinMode(PIN_DRIVER_ENABLE, OUTPUT);
      digitalWrite(PIN_DRIVER_ENABLE, HIGH);
    }

  private:
    float handleMeasurement() override {
      // A voltage 10/100k divider.
      return 36.f * ADC.readChannel(V2Base::Analog::ADC::getChannel(PIN_VOLTAGE_SENSE));
    }

    void handleOn() override {
      digitalWrite(PIN_DRIVER_ENABLE, LOW);
    }

    void handleOff() override {
      digitalWrite(PIN_DRIVER_ENABLE, HIGH);
    }

    void handleNotify(float voltage) override {
      // Power interruption, or commands without a power connection show yellow LEDs.
      if (voltage < config.min) {
        LED.flash({V2Colour::Yellow, 1, 0.5}, 0.5);
        return;
      }

      // Over-voltage shows red LEDs.
      if (voltage > config.max) {
        LED.flash({V2Colour::Red, 1, 1}, 0.5);
        return;
      }

      // The number of green LEDs shows the voltage.
      const float fraction{voltage / (float)config.max};
      const float n{ceil((float)nSteppers * fraction)};
      LED.flash({V2Colour::Green, 1, 0.5}, 0.5, 0, n);
    }
  } Power;

  class Device : public V2Device {
  public:
    Device() : V2Device() {
      metadata.vendor      = "Versio Duo";
      metadata.product     = "V2 step";
      metadata.description = "Stepper Motor Controller";
      metadata.home        = "https://versioduo.com/#step";
      system.download      = "https://versioduo.com/download";
      system.configure     = "https://versioduo.com/configure";
    }

  private:
    struct {
      int16_t pitchBend;
      float   rotate;
    } _steppers[nSteppers]{};

    void handleReset() override {
      LED.reset();

      for (uint8_t i = 0; i < nSteppers; i++) {
        _steppers[i] = {};
        Steppers[i].reset();
      }

      Power.off();
    }

    void allNotesOff() {
      reset();
    }

    bool power() {
      bool continuous;
      if (!Power.on(continuous))
        return false;

      if (!continuous)
        for (auto& s : Steppers)
          s.reset();

      return true;
    }

    void play(uint8_t channel, uint8_t note, uint8_t velocity) {
      if (channel >= nSteppers)
        return;

      if (note < V2MIDI::A(-1) || note > V2MIDI::A(-1) + 88)
        return;

      if (velocity == 0) {
        Steppers[channel].stop();
        return;
      }

      if (!power())
        return;

      auto range{float(note - V2MIDI::A(-1)) / 87.f};
      auto speed{float(velocity) / 127.f};
      Steppers[channel].setPosition(range * 200.f * 44.f, powf(speed, 3));
    }

    void handleNote(uint8_t channel, uint8_t note, uint8_t velocity) override {
      play(channel, note, velocity);
    }

    void handleNoteOff(uint8_t channel, uint8_t note, uint8_t velocity) override {
      play(channel, note, 0);
    }

    void handleControlChange(uint8_t channel, uint8_t controller, uint8_t value) override {
      if (channel != 0)
        return;

      switch (controller) {
        case V2MIDI::CC::AllSoundOff:
        case V2MIDI::CC::AllNotesOff:
          allNotesOff();
          break;
      }
    }

    void handlePitchBend(uint8_t channel, int16_t value) override {
      if (channel >= nSteppers)
        return;

      _steppers[channel].pitchBend = value;

      // Negative range, the chosen exponent needs to preserve the sign.
      const float fraction{(float)value / (value < 0 ? 8192.f : 8191.f)};
      _steppers[channel].rotate = powf(fraction, 3);

      if (!power())
        return;

      Steppers[channel].rotate(_steppers[channel].rotate);
    }

    void handleSystemReset() override {
      reset();
    }

    void exportSystem(JsonObject json) override {
      JsonObject jsonPower       = json["power"].to<JsonObject>();
      jsonPower["voltage"]       = serialized(String(Power.getVoltage(), 1));
      jsonPower["interruptions"] = Power.getInterruptions();
    }

    void exportInput(JsonObject json) override {
      JsonArray jsonChannels = json["channels"].to<JsonArray>();
      for (uint8_t ch = 0; ch < nSteppers; ch++) {
        JsonObject jsonChannel = jsonChannels.add<JsonObject>();
        jsonChannel["number"]  = ch;

        {
          JsonObject jsonPitchbend = jsonChannel["pitchbend"].to<JsonObject>();
          jsonPitchbend["value"]   = _steppers[ch].pitchBend;
        }

        {
          JsonObject jsonChromatic = jsonChannel["chromatic"].to<JsonObject>();
          jsonChromatic["start"]   = V2MIDI::A(-1);
          jsonChromatic["count"]   = 88;
        }
      }
    }
  } Device;

  // Dispatch MIDI packets.
  class MIDI {
  public:
    void loop() {
      if (!Device.usb.midi.receive(_midi))
        return;

      if (_midi.port == 0) {
        Device.dispatch(&Device.usb.midi, &_midi);

      } else {
        V2Link::Packet p(_midi.port - 1, _midi);
        p.midi.port = 0;
        Socket.send(p);
      }
    }

  private:
    V2MIDI::Packet _midi{};
  } MIDI;

  // Dispatch Link packets.
  class Link : public V2Link {
  public:
    Link() : V2Link(&Plug, &Socket) {
      Device.link = this;
    }

  private:
    // Receive a host event from our parent device.
    void receivePlug(V2Link::Packet& p) override {
      if (p.type == V2Link::Packet::Type::MIDI)
        Device.dispatch(&Plug, &p.midi);
    }

    // Forward children device events to the host.
    void receiveSocket(V2Link::Packet& p) override {
      if (p.type == V2Link::Packet::Type::MIDI) {
        p.midi.port = p.address;
        Device.usb.midi.send(p.midi);
      }
    }
  } Link;

  class Button : public V2Buttons::Button {
  public:
    Button() : V2Buttons::Button(&_config, PIN_BUTTON) {}

  private:
    const V2Buttons::Config _config{.clickUsec{200 * 1000}, .holdUsec{500 * 1000}};

    void handleClick(uint8_t count) override {
      Device.reset();
    }

    void handleHold(uint8_t count) override {
      LED.hsv({V2Colour::Cyan, 1, 0.25}, nSteppers + 0, 2);
    }

    void handleRelease() override {}
  } Button;
}

void setup() {
  Serial.begin(9600);
  SPI.begin();

  LED.begin();
  LED.brightnessMax(0.5);

  Plug.begin();
  Socket.begin();
  Device.link = &Link;

  // Set the SERCOM interrupt priority, it requires a stable ~300 kHz interrupt
  // frequency. This needs to be after begin().
  setSerialPriority(&SerialPlug, 2);
  setSerialPriority(&SerialSocket, 1);

  Power.begin();
  for (auto& s : Steppers)
    s.begin();

  // The priority needs to be lower than the SERCOM priorities.
  Timer.begin([]() {
    for (auto& s : Steppers)
      s.tick();
  });
  Timer.setPriority(3);

  ADC.begin();
  ADC.addChannel(V2Base::Analog::ADC::getChannel(PIN_VOLTAGE_SENSE));

  Device.begin();
  Button.begin();
  Device.reset();
}

void loop() {
  for (auto& s : Steppers)
    s.loop();

  LED.loop();
  MIDI.loop();
  Link.loop();
  V2Buttons::loop();
  Power.loop();
  Device.loop();

  if (Link.idle() && Device.idle())
    Device.sleep();
}
