versioduo/step/(commit log)

2026-01-11 Update front + back
    [back.kicad_pcb, front.kicad_pcb]
2026-01-12 Update parts library
    [LinkPlug.kicad_sch, LinkSocket.kicad_sch, StepperDriver.kicad_sch, button-laser.dxf, step-cover.kicad_pcb, step-cover.kicad_sch, step.kicad_pcb, step.kicad_sch]
2026-01-14 Update parts
    [LinkPlug.kicad_sch, LinkSocket.kicad_sch, StepperDriver.kicad_sch, step.kicad_pcb, step.kicad_sch]
2026-02-01 Update library
    [StepperDriver.kicad_sch, step.kicad_pcb, step.kicad_sch]
2026-02-10 Use date as revision
    [step.kicad_pcb, step.kicad_sch]
2026-02-13 Replace Order_Number
    [LinkPlug.kicad_sch, StepperDriver.kicad_sch, step.kicad_pcb, step.kicad_sch]
2026-03-12 Update sheet metal
    [back.kicad_pcb, back.kicad_sch]
2026-03-14 Update ESD suppressor
    [step.kicad_pcb, step.kicad_sch]
2026-03-21 KiCad 10
    [LinkPlug.kicad_sch, LinkSocket.kicad_sch, StepperDriver.kicad_sch, step.kicad_pcb, step.kicad_sch]
2026-05-11 Good Bye Imperial
    [LinkPlug.kicad_sch, LinkSocket.kicad_sch, StepperDriver.kicad_sch, step.kicad_pcb, step.kicad_sch]
2026-05-27 Switch to 6 layer
    [LinkPlug.kicad_sch, LinkSocket.kicad_sch, StepperDriver.kicad_sch, step.kicad_pcb, step.kicad_sch]
